EclipseETS/bms-slave-HW/E10/V1/Slave_front.png

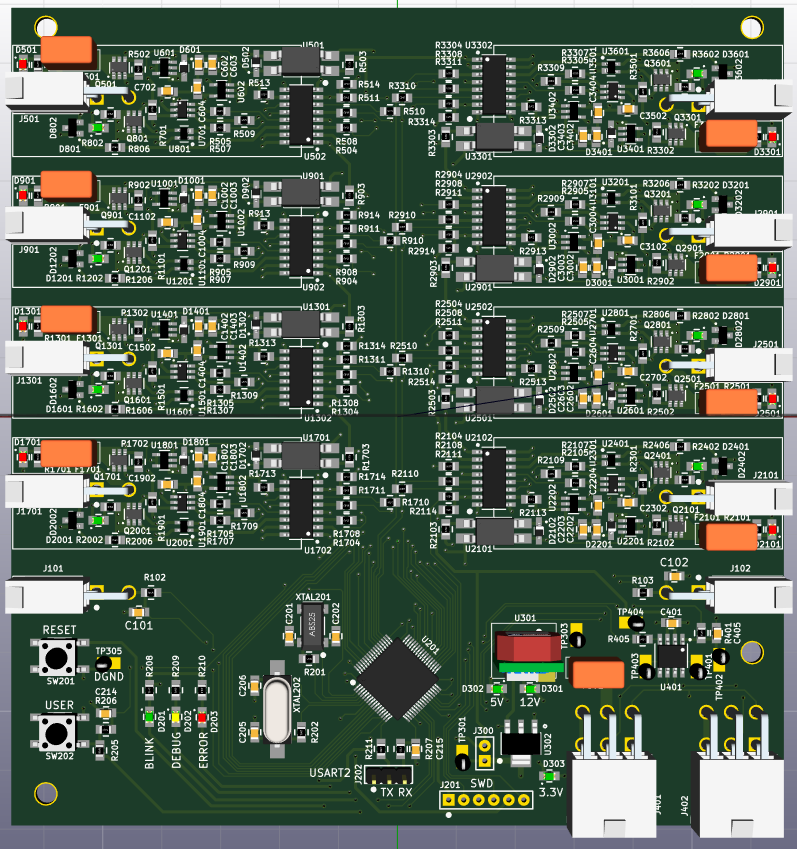
E10/V1/Slave_front.png
