EclipseETS/bms-slave-HW/README.md

# bms-slave-HW
Kicad project for slave board of the Eclipse solar car BMS
