EclipseETS/bms-slave-HW/E10/V1/Slave_back.png

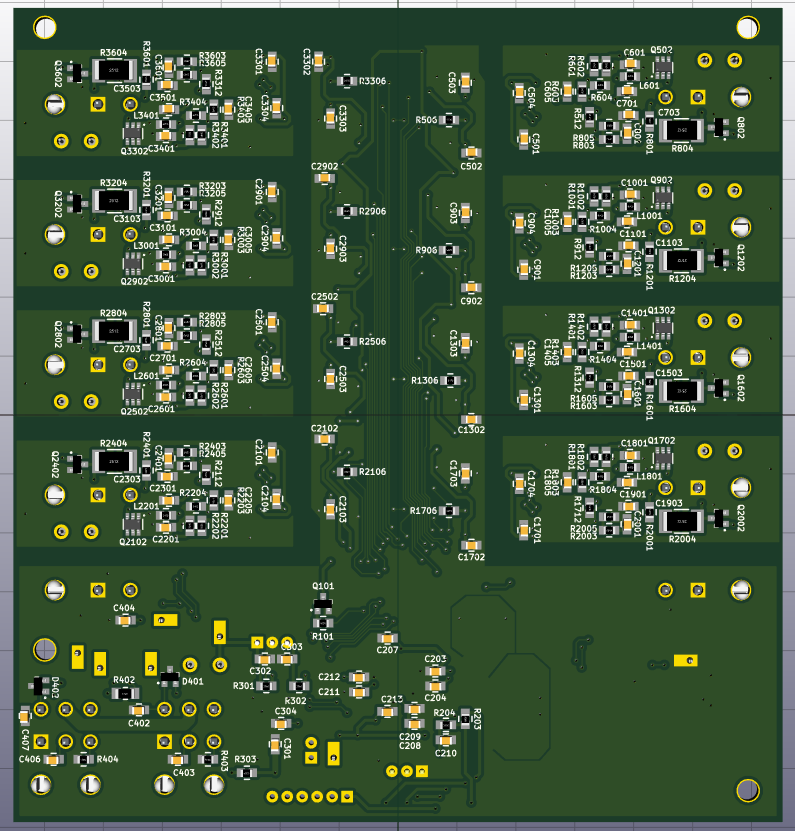
E10/V1/Slave_back.png
