EclipseETS/bms-slave-HW/E11/V1/Slave.kicad_pcb

## KiCad design E11/V1/Slave.kicad_pcb (2021-01-23)

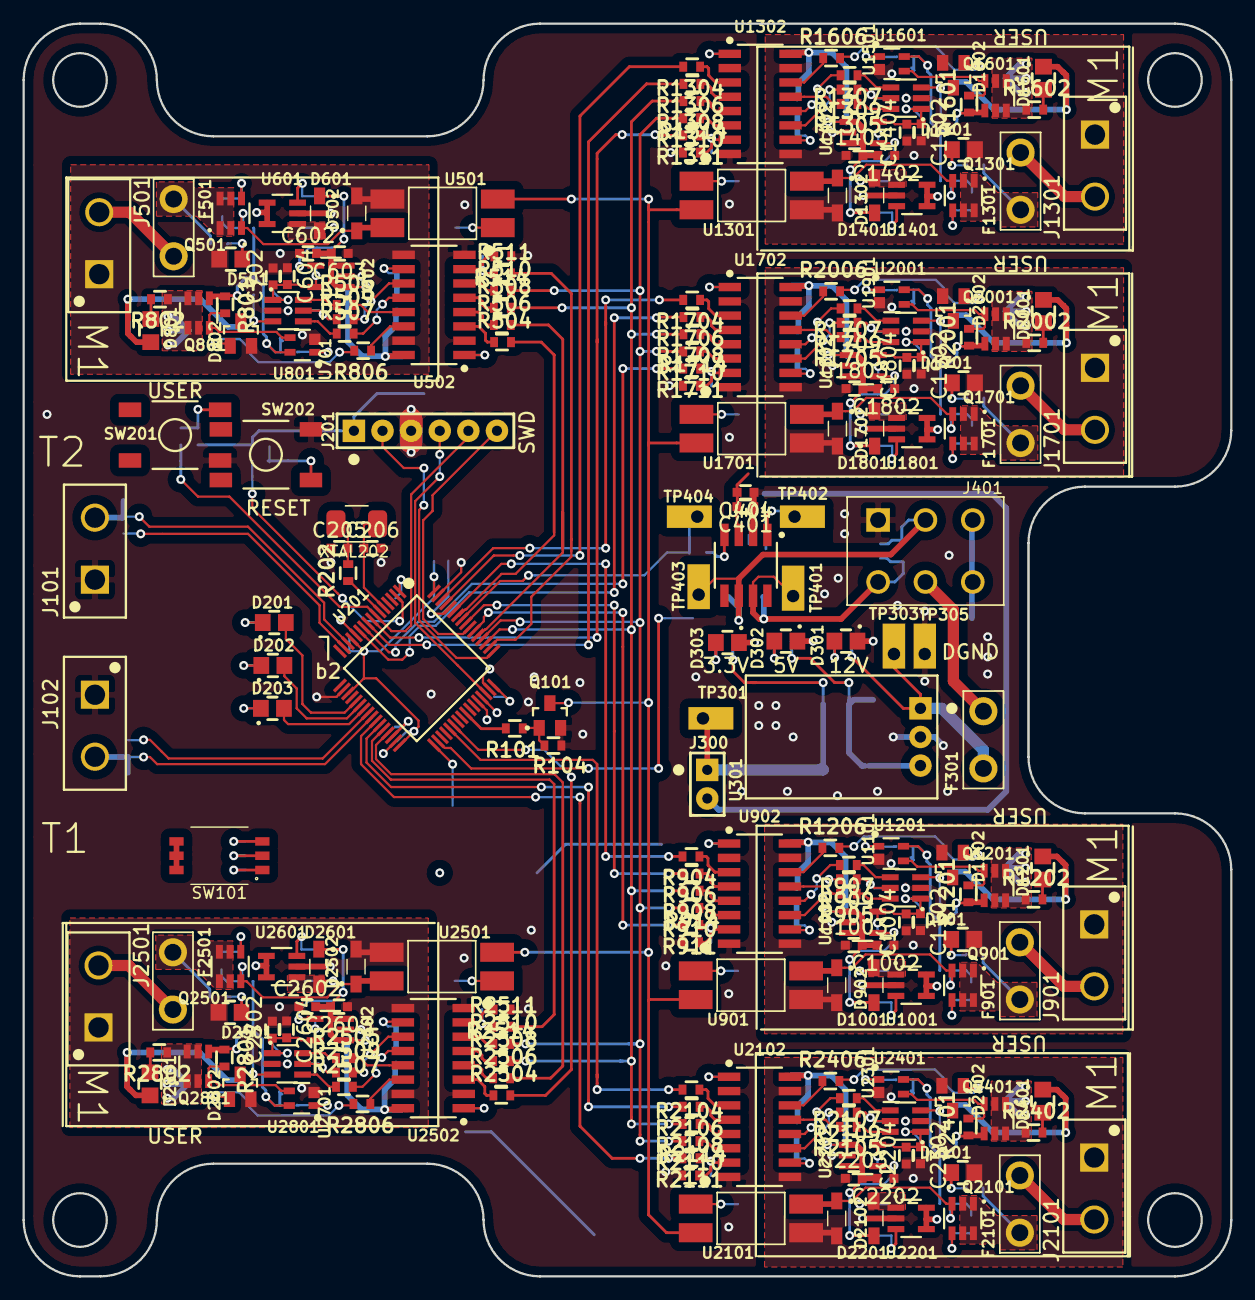
[picture p4: board Slave.kicad_pcb from above]

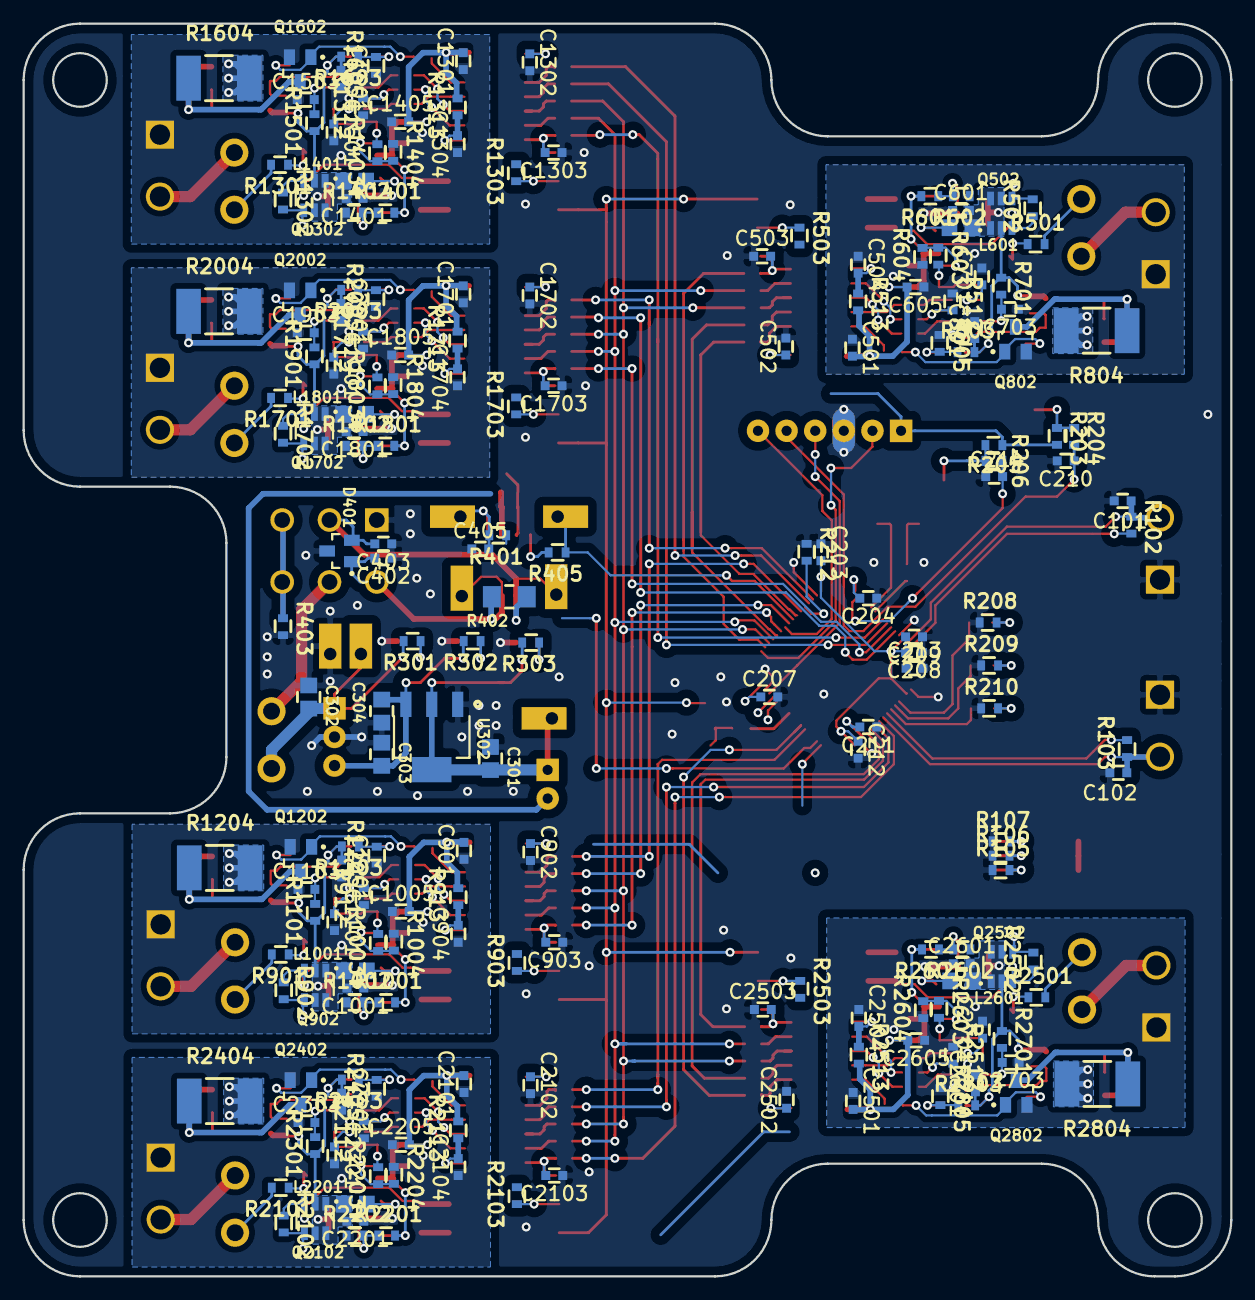
[picture p5: board Slave.kicad_pcb from below]

Board: 2 copper layers, 107.2 x 111.2 mm, 411 parts (191 on the bottom side), 263 nets.

Parts:
C101, C102, C204, C208, C401: 885012107015; C0603
C203, C207, C210, C212, C213, C214, C404: 885012207098; C0603
C205, C206, C402, C403: 885012007053; C0603
C209: 885012207092; C0603
C211: 885012107018; C0603
C301: 885012107005; C0805
C302, C303: 885012107018; C0805
C304: 885012107014; C0805
C405: 885012207080; C0603
C501, C502, C504, C702, C801, C901, C902, C904, C1102, C1201, C1301, C1302, C1304, C1502, C1601, C1701, C1702, C1704, C1902, C2001, C2101, C2102, C2104, C2302, C2401, C2501, C2502, C2504, C2702, C2801: 885012206095; C0603
C503, C903, C1303, C1703, C2103, C2503: 885012206077; C0603
C601, C602, C603, C604, C605, C1001, C1002, C1003, C1004, C1005, C1401, C1402, C1403, C1404, C1405, C1801, C1802, C1803, C1804, C1805, C2201, C2202, C2203, C2204, C2205, C2601, C2602, C2603, C2604, C2605: GRM188R61C106KAALD; C0603
C701, C1101, C1501, C1901, C2301, C2701: 885012106022; C0603
C703, C1103, C1503, C1903, C2303, C2703: 885012206073; C0603
D201, D301, D302, D303, D801, D1201, D1601, D2001, D2401, D2801: 150080VS75000; LED_0805_GREEN
D202: 150080YS75000; LED_0805_YELLOW
D203, D501, D901, D1301, D1701, D2101, D2501: 150080RS75000; LED_0805_RED
D401: D1213A-02SOL-7; SOT-23-3
D502, D601, D902, D1001, D1302, D1401, D1702, D1801, D2102, D2201, D2502, D2601: NSR0530HT1G; SOD-323
D802, D1202, D1602, D2002, D2402, D2802: MMBZ12VALT1G; SOT-23-3
F301, F501, F901, F1301, F1701, F2101, F2501: 39511000440; TE5_395
J101, J102, J501, J901, J1301, J1701, J2101, J2501: 64900221122
J201: Header_Male_Pin_2.54mm_1X6_,_Unshrouded; Headers_2.54mm_1X6
J300: Header_Male_Pin_2.54mm_1X2_,_Unshrouded; Headers_2.54mm_1X2
J401: 64900621122
L601, L1001, L1401, L1801, L2201, L2601: MLZ2012N101LT000; I0805
Q101: 2N7002P,215; SOT-23-3
Q501, Q502, Q801, Q901, Q902, Q1201, Q1301, Q1302, Q1601, Q1701, Q1702, Q2001, Q2101, Q2102, Q2401, Q2501, Q2502, Q2801: CPH6347-TL-W; TSOT-23-6
Q802, Q1202, Q1602, Q2002, Q2402, Q2802: BSS806NH6327XTSA1; SOT-23-3
R101, R208, R209, R210, R303: RC0805JR-07470RL; R0603
R102, R103: RC0805JR-0733KL; R0603
R104, R203, R205, R301: RC0805JR-074K7L; R0603
R105, R106, R107: RC0603JR-07470RL; R0603
R202, R403: RC0805JR-070RL; R0603
R204, R206, R401, R405: RC0805JR-07100RL; R0603
R212: RC0805JR-0710KL; R0603
R302: RC0805JR-071KL; R0603
R402: RC1206JR-07120RL; R1206
R501, R802, R901, R1202, R1301, R1602, R1701, R2002, R2101, R2402, R2501, R2802: RC0603JR-071KL; R0603
R502, R514, R801, R902, R914, R1201, R1302, R1314, R1601, R1702, R1714, R2001, R2102, R2114, R2401, R2502, R2514, R2801: RC0603JR-07470KL; R0603
R503, R903, R1303, R1703, R2103, R2503: RC0603JR-07330RL; R0603
R504, R505, R506, R507, R508, R509, R701, R904, R905, R906, R907, R908, R909, R1101, R1304, R1305, R1306, R1307, R1308, R1309, R1501, R1704, R1705, R1706, R1707, R1708, R1709, R1901, R2104, R2105, R2106, R2107, R2108, R2109, R2301, R2504, R2505, R2506, R2507, R2508, R2509, R2701: RC0603FR-07100RL; R0603
R510, R511, R512, R513, R603, R910, R911, R912, R913, R1003, R1310, R1311, R1312, R1313, R1403, R1710, R1711, R1712, R1713, R1803, R2110, R2111, R2112, R2113, R2203, R2510, R2511, R2512, R2513, R2603: RC0603JR-074K7L; R0603
R601, R1001, R1401, R1801, R2201, R2601: RC0603JR-071ML; R0603
R602, R1002, R1402, R1802, R2202, R2602: RC0603FR-07324KL; R0603
R604, R1004, R1404, R1804, R2204, R2604: RC0603FR-0712K1L; R0603
R803, R1203, R1603, R2003, R2403, R2803: RC0603JR-07560KL; R0603
R804, R1204, R1604, R2004, R2404, R2804: 352210RJT; R2512
R805, R1205, R1605, R2005, R2405, R2805: RC0603JR-07100KL; R0603
R806, R1206, R1606, R2006, R2406, R2806: RC0603JR-076K8L; R0603
SW101: DIP_SW_3; 416131160803
SW201, SW202: PTS645SM43SMTR92; PTS645_6X6X4_SMD
TP301, TP303, TP305, TP401, TP402, TP403, TP404: Test_Point_THM; Keystone_5001
U201: STM32F446RE; LQFP-64
U301: OKI-78SR-5/1.5-W36-C; OKI-78SR_Horizontal
U302: AZ1117IH-3.3TRG1; SOT-223-3
U401: SN65HVD232DR; SOIC-8
U501, U901, U1301, U1701, U2101, U2501: LTV-816S; 4-SMD
U502, U902, U1302, U1702, U2102, U2502: SI8641AB-B-IS1; SOIC-16
U601, U1001, U1401, U1801, U2201, U2601: AP3015KTR-G1; SOT-23-5
U602, U1002, U1402, U1802, U2202, U2602: AP2202K-ADJTRG1; SOT-23-5
U701, U1101, U1501, U1901, U2301, U2701: ADC121S021CIMF/NOPB; SOT-23-6
U801, U1201, U1601, U2001, U2401, U2801: ADCMP350YKSZ-REEL7; SC70-4
XTAL202: 7A-8.000MAHJ-T; TXC_7A_Series

Connections:
3.3V: C301.2, J300.1, R303.2, TP301.1, U302.2, U302.4
5V: C303.2, C304.2, R302.2, U301.3, U302.3
12V: C302.2, F301.2, R301.2, TP303.1, U301.1
/BALANCING_PWM_1: R504.2, U201.58
/BALANCING_PWM_2: R904.2, U201.59
/BALANCING_PWM_3: R1304.2, U201.61
/BALANCING_PWM_4: R1704.2, U201.62
/BALANCING_PWM_5: R2104.2, U201.37
/BALANCING_PWM_6: R2504.2, U201.38
/CAN1/CAN_N: C403.2, D401.2, J401.2, R402.2, TP403.1, U401.6
/CAN1/CAN_P: C402.2, D401.1, J401.4, R402.1, TP401.1, U401.7
/CAN1/Shield1: J401.3, J401.6, R403.1
/CAN2_RX: R405.1, TP404.1, U201.57
/CAN2_TX: R401.1, U201.34
/CS_1: R506.2, U201.53
/CS_2: R906.2, U201.56
/CS_3: R1306.2, U201.9
/CS_4: R1706.2, U201.11
/CS_5: R2106.2, U201.27
/CS_6: R2506.2, U201.29
/DATA_ENABLE_1: R511.2, U201.50
/DATA_ENABLE_2: R911.2, U201.54
/DATA_ENABLE_3: R1311.2, U201.8
/DATA_ENABLE_4: R1711.2, U201.10
/DATA_ENABLE_5: R2111.2, U201.26
/DATA_ENABLE_6: R2511.2, U201.28
/ID_0: R105.2, SW101.1, U201.33
/ID_1: R106.2, SW101.2, U201.44
/ID_2: R107.2, SW101.3, U201.45
/MISO: R510.2, R910.2, R1310.2, R1710.2, R2110.2, R2510.2, U201.52
/Module 1/+VREF: C604.2, C701.1, C702.1, R603.2, U602.5, U701.1
/Module 1/BALANCE_PWM: R806.1, U502.14
/Module 1/BVDD: C501.2, C602.2, C603.2, C605.2, D601.1, R513.2, R601.2, U502.16, U602.1, U602.3
/Module 1/Balancing/Drain_P_Mosfet: Q801.1, Q801.2, Q801.5, Q801.6, R802.1, R804.2
/Module 1/CELL+: F501.2, Q501.1, Q501.2, Q501.5, Q501.6, R501.2
/Module 1/CELL-: C501.1, C504.1, C601.1, C602.1, C603.1, C604.1, C605.1, C701.2, C702.2, C703.1, C801.2, D501.2, D502.2, D802.2, J501.1, Q802.2, R512.1, R602.1, R604.1, R805.1, U501.3, U502.9, U502.15, U601.2, U602.2, U701.2, U801.2
/Module 1/CELL_Voltage: C601.2, C801.1, L601.1, Q502.1, Q502.2, Q502.5, Q502.6, Q801.4, R701.1, R801.1, R803.2, U601.4, U601.5, U801.4
/Module 1/CS: R505.2, U502.13
/Module 1/Power Supply Front End/SW: D601.2, L601.2, U601.1
/Module 1/SCLK: R507.2, U502.12
/Module 1/SDATA: R509.2, U502.11
/Module 1/Voltage Reading/CS: R505.1, U701.6
/Module 1/Voltage Reading/SCLK: R507.1, U701.4
/Module 1/Voltage Reading/SDATA: R509.1, R512.2, U701.5
/Module 2/+VREF: C1004.2, C1101.1, C1102.1, R1003.2, U1002.5, U1101.1
/Module 2/BALANCE_PWM: R1206.1, U902.14
/Module 2/BVDD: C901.2, C1002.2, C1003.2, C1005.2, D1001.1, R913.2, R1001.2, U902.16, U1002.1, U1002.3
/Module 2/Balancing/Drain_P_Mosfet: Q1201.1, Q1201.2, Q1201.5, Q1201.6, R1202.1, R1204.2
/Module 2/CELL+: F901.2, Q901.1, Q901.2, Q901.5, Q901.6, R901.2
/Module 2/CELL-: C901.1, C904.1, C1001.1, C1002.1, C1003.1, C1004.1, C1005.1, C1101.2, C1102.2, C1103.1, C1201.2, D901.2, D902.2, D1202.2, J901.1, Q1202.2, R912.1, R1002.1, R1004.1, R1205.1, U901.3, U902.9, U902.15, U1001.2, U1002.2, U1101.2, U1201.2
/Module 2/CELL_Voltage: C1001.2, C1201.1, L1001.1, Q902.1, Q902.2, Q902.5, Q902.6, Q1201.4, R1101.1, R1201.1, R1203.2, U1001.4, U1001.5, U1201.4
/Module 2/CS: R905.2, U902.13
/Module 2/Power Supply Front End/SW: D1001.2, L1001.2, U1001.1
/Module 2/SCLK: R907.2, U902.12
/Module 2/SDATA: R909.2, U902.11
/Module 2/Voltage Reading/CS: R905.1, U1101.6
/Module 2/Voltage Reading/SCLK: R907.1, U1101.4
/Module 2/Voltage Reading/SDATA: R909.1, R912.2, U1101.5
/Module 3/+VREF: C1404.2, C1501.1, C1502.1, R1403.2, U1402.5, U1501.1
/Module 3/BALANCE_PWM: R1606.1, U1302.14
/Module 3/BVDD: C1301.2, C1402.2, C1403.2, C1405.2, D1401.1, R1313.2, R1401.2, U1302.16, U1402.1, U1402.3
/Module 3/Balancing/Drain_P_Mosfet: Q1601.1, Q1601.2, Q1601.5, Q1601.6, R1602.1, R1604.2
/Module 3/CELL+: F1301.2, Q1301.1, Q1301.2, Q1301.5, Q1301.6, R1301.2
/Module 3/CELL-: C1301.1, C1304.1, C1401.1, C1402.1, C1403.1, C1404.1, C1405.1, C1501.2, C1502.2, C1503.1, C1601.2, D1301.2, D1302.2, D1602.2, J1301.1, Q1602.2, R1312.1, R1402.1, R1404.1, R1605.1, U1301.3, U1302.9, U1302.15, U1401.2, U1402.2, U1501.2, U1601.2
/Module 3/CELL_Voltage: C1401.2, C1601.1, L1401.1, Q1302.1, Q1302.2, Q1302.5, Q1302.6, Q1601.4, R1501.1, R1601.1, R1603.2, U1401.4, U1401.5, U1601.4
/Module 3/CS: R1305.2, U1302.13
/Module 3/Power Supply Front End/SW: D1401.2, L1401.2, U1401.1
/Module 3/SCLK: R1307.2, U1302.12
/Module 3/SDATA: R1309.2, U1302.11
/Module 3/Voltage Reading/CS: R1305.1, U1501.6
/Module 3/Voltage Reading/SCLK: R1307.1, U1501.4
/Module 3/Voltage Reading/SDATA: R1309.1, R1312.2, U1501.5
/Module 4/+VREF: C1804.2, C1901.1, C1902.1, R1803.2, U1802.5, U1901.1
/Module 4/BALANCE_PWM: R2006.1, U1702.14
/Module 4/BVDD: C1701.2, C1802.2, C1803.2, C1805.2, D1801.1, R1713.2, R1801.2, U1702.16, U1802.1, U1802.3
/Module 4/Balancing/Drain_P_Mosfet: Q2001.1, Q2001.2, Q2001.5, Q2001.6, R2002.1, R2004.2
/Module 4/CELL+: F1701.2, Q1701.1, Q1701.2, Q1701.5, Q1701.6, R1701.2
/Module 4/CELL-: C1701.1, C1704.1, C1801.1, C1802.1, C1803.1, C1804.1, C1805.1, C1901.2, C1902.2, C1903.1, C2001.2, D1701.2, D1702.2, D2002.2, J1701.1, Q2002.2, R1712.1, R1802.1, R1804.1, R2005.1, U1701.3, U1702.9, U1702.15, U1801.2, U1802.2, U1901.2, U2001.2
/Module 4/CELL_Voltage: C1801.2, C2001.1, L1801.1, Q1702.1, Q1702.2, Q1702.5, Q1702.6, Q2001.4, R1901.1, R2001.1, R2003.2, U1801.4, U1801.5, U2001.4
/Module 4/CS: R1705.2, U1702.13
/Module 4/Power Supply Front End/SW: D1801.2, L1801.2, U1801.1
/Module 4/SCLK: R1707.2, U1702.12
/Module 4/SDATA: R1709.2, U1702.11
/Module 4/Voltage Reading/CS: R1705.1, U1901.6
/Module 4/Voltage Reading/SCLK: R1707.1, U1901.4
/Module 4/Voltage Reading/SDATA: R1709.1, R1712.2, U1901.5
/Module 5/+VREF: C2204.2, C2301.1, C2302.1, R2203.2, U2202.5, U2301.1
/Module 5/BALANCE_PWM: R2406.1, U2102.14
/Module 5/BVDD: C2101.2, C2202.2, C2203.2, C2205.2, D2201.1, R2113.2, R2201.2, U2102.16, U2202.1, U2202.3
/Module 5/Balancing/Drain_P_Mosfet: Q2401.1, Q2401.2, Q2401.5, Q2401.6, R2402.1, R2404.2
/Module 5/CELL+: F2101.2, Q2101.1, Q2101.2, Q2101.5, Q2101.6, R2101.2
/Module 5/CELL-: C2101.1, C2104.1, C2201.1, C2202.1, C2203.1, C2204.1, C2205.1, C2301.2, C2302.2, C2303.1, C2401.2, D2101.2, D2102.2, D2402.2, J2101.1, Q2402.2, R2112.1, R2202.1, R2204.1, R2405.1, U2101.3, U2102.9, U2102.15, U2201.2, U2202.2, U2301.2, U2401.2
/Module 5/CELL_Voltage: C2201.2, C2401.1, L2201.1, Q2102.1, Q2102.2, Q2102.5, Q2102.6, Q2401.4, R2301.1, R2401.1, R2403.2, U2201.4, U2201.5, U2401.4
/Module 5/CS: R2105.2, U2102.13
/Module 5/Power Supply Front End/SW: D2201.2, L2201.2, U2201.1
/Module 5/SCLK: R2107.2, U2102.12
/Module 5/SDATA: R2109.2, U2102.11
/Module 5/Voltage Reading/CS: R2105.1, U2301.6
/Module 5/Voltage Reading/SCLK: R2107.1, U2301.4
/Module 5/Voltage Reading/SDATA: R2109.1, R2112.2, U2301.5
/Module 6/+VREF: C2604.2, C2701.1, C2702.1, R2603.2, U2602.5, U2701.1
/Module 6/BALANCE_PWM: R2806.1, U2502.14
/Module 6/BVDD: C2501.2, C2602.2, C2603.2, C2605.2, D2601.1, R2513.2, R2601.2, U2502.16, U2602.1, U2602.3
/Module 6/Balancing/Drain_P_Mosfet: Q2801.1, Q2801.2, Q2801.5, Q2801.6, R2802.1, R2804.2
/Module 6/CELL+: F2501.2, Q2501.1, Q2501.2, Q2501.5, Q2501.6, R2501.2
/Module 6/CELL-: C2501.1, C2504.1, C2601.1, C2602.1, C2603.1, C2604.1, C2605.1, C2701.2, C2702.2, C2703.1, C2801.2, D2501.2, D2502.2, D2802.2, J2501.1, Q2802.2, R2512.1, R2602.1, R2604.1, R2805.1, U2501.3, U2502.9, U2502.15, U2601.2, U2602.2, U2701.2, U2801.2
/Module 6/CELL_Voltage: C2601.2, C2801.1, L2601.1, Q2502.1, Q2502.2, Q2502.5, Q2502.6, Q2801.4, R2701.1, R2801.1, R2803.2, U2601.4, U2601.5, U2801.4
/Module 6/CS: R2505.2, U2502.13
/Module 6/Power Supply Front End/SW: D2601.2, L2601.2, U2601.1
/Module 6/SCLK: R2507.2, U2502.12
/Module 6/SDATA: R2509.2, U2502.11
/Module 6/Voltage Reading/CS: R2505.1, U2701.6
/Module 6/Voltage Reading/SCLK: R2507.1, U2701.4
/Module 6/Voltage Reading/SDATA: R2509.1, R2512.2, U2701.5
/NRST: C210.1, J201.5, R204.2, U201.7
/NTC_1_ADC: C101.2, J101.2, R102.1, U201.14
/NTC_1_GPIO: R102.2, U201.15
/NTC_2_ADC: C102.2, J102.2, R103.1, U201.25
/NTC_2_GPIO: R103.2, U201.24
/PA5: D201.2, U201.21
/PA6: D202.2, U201.22
/PA7: D203.2, U201.23
/PWR_ENABLE: Q101.3, U501.2, U901.2, U1301.2, U1701.2, U2101.2, U2501.2
/PWR_ENABLE_GPIO: R101.2, U201.41
/SCLK: R508.2, R908.2, R1308.2, R1708.2, R2108.2, R2508.2, U201.51
/STM32F446/SWCLK: J201.2, U201.49
/STM32F446/SWDIO: J201.4, U201.46
/STM32F446/SWO: J201.6, U201.55
/STM32F446/USER_BTN: C214.1, R206.2, U201.2
/VBat: C204.2, U201.1
CAN_PWR: F301.1, J401.5
DGND: C101.1, C102.1, C203.1, C204.1, C205.1, C206.2, C207.2, C208.1, C209.1, C210.2, C211.1, C212.2, C213.2, C214.2, C301.1, C302.1, C303.1, C304.1, C401.1, C402.1, C403.1, C404.1, C405.1, C502.2, C503.1, C902.2, C903.1, C1302.2, C1303.1, C1702.2, C1703.1, C2102.2, C2103.1, C2502.2, C2503.1, D301.1, D302.1, D303.1, D401.3, J101.1, J102.1, J201.3, J401.1, Q101.2, R104.1, R105.1, R106.1, R107.1, R208.1, R209.1, R210.1, R212.1, R403.2, R514.1, R914.1, R1314.1, R1714.1, R2114.1, R2514.1, SW201.4, SW202.3, TP305.1, U201.12, U201.18, U201.31, U201.47, U201.63, U301.2, U302.1, U401.2, U502.2, U502.8, U902.2, U902.8, U1302.2, U1302.8, U1702.2, U1702.8, U2102.2, U2102.8, U2502.2, U2502.8
unnamed: C205.2, R202.2, XTAL202.1
unnamed: C206.1, U201.5, XTAL202.2
unnamed: C211.2, U201.30
unnamed: C405.2, R401.2, TP402.1, U401.1
unnamed: C503.2, R511.1, R514.2, U502.7
unnamed: C504.2, R513.1, U502.10
unnamed: C703.2, R701.2, U701.3
unnamed: C903.2, R911.1, R914.2, U902.7
unnamed: C904.2, R913.1, U902.10
unnamed: C1103.2, R1101.2, U1101.3
unnamed: C1303.2, R1311.1, R1314.2, U1302.7
unnamed: C1304.2, R1313.1, U1302.10
unnamed: C1503.2, R1501.2, U1501.3
unnamed: C1703.2, R1711.1, R1714.2, U1702.7
unnamed: C1704.2, R1713.1, U1702.10
unnamed: C1903.2, R1901.2, U1901.3
unnamed: C2103.2, R2111.1, R2114.2, U2102.7
unnamed: C2104.2, R2113.1, U2102.10
unnamed: C2303.2, R2301.2, U2301.3
unnamed: C2503.2, R2511.1, R2514.2, U2502.7
unnamed: C2504.2, R2513.1, U2502.10
unnamed: C2703.2, R2701.2, U2701.3
unnamed: D201.1, R208.2
unnamed: D202.1, R209.2
unnamed: D203.1, R210.2
unnamed: D301.2, R301.1
unnamed: D302.2, R302.1
unnamed: D303.2, R303.1
unnamed: D501.1, R501.1
unnamed: D502.1, Q501.3, Q502.3, R502.1, U501.4
unnamed: D801.1, Q802.3, R804.1
unnamed: D801.2, R802.2
unnamed: D802.1, Q802.1, R806.2
unnamed: D901.1, R901.1
unnamed: D902.1, Q901.3, Q902.3, R902.1, U901.4
unnamed: D1201.1, Q1202.3, R1204.1
unnamed: D1201.2, R1202.2
unnamed: D1202.1, Q1202.1, R1206.2
unnamed: D1301.1, R1301.1
unnamed: D1302.1, Q1301.3, Q1302.3, R1302.1, U1301.4
unnamed: D1601.1, Q1602.3, R1604.1
unnamed: D1601.2, R1602.2
unnamed: D1602.1, Q1602.1, R1606.2
unnamed: D1701.1, R1701.1
unnamed: D1702.1, Q1701.3, Q1702.3, R1702.1, U1701.4
unnamed: D2001.1, Q2002.3, R2004.1
unnamed: D2001.2, R2002.2
unnamed: D2002.1, Q2002.1, R2006.2
unnamed: D2101.1, R2101.1
unnamed: D2102.1, Q2101.3, Q2102.3, R2102.1, U2101.4
unnamed: D2401.1, Q2402.3, R2404.1
unnamed: D2401.2, R2402.2
unnamed: D2402.1, Q2402.1, R2406.2
unnamed: D2501.1, R2501.1
unnamed: D2502.1, Q2501.3, Q2502.3, R2502.1, U2501.4
unnamed: D2801.1, Q2802.3, R2804.1
unnamed: D2801.2, R2802.2
unnamed: D2802.1, Q2802.1, R2806.2
unnamed: F501.1, J501.2
unnamed: F901.1, J901.2
unnamed: F1301.1, J1301.2
unnamed: F1701.1, J1701.2
unnamed: F2101.1, J2101.2
unnamed: F2501.1, J2501.2
unnamed: Q101.1, R101.1, R104.2
unnamed: Q501.4, Q502.4, R502.2
unnamed: Q801.3, R801.2, U801.3
unnamed: Q901.4, Q902.4, R902.2
unnamed: Q1201.3, R1201.2, U1201.3
unnamed: Q1301.4, Q1302.4, R1302.2
unnamed: Q1601.3, R1601.2, U1601.3
unnamed: Q1701.4, Q1702.4, R1702.2
unnamed: Q2001.3, R2001.2, U2001.3
unnamed: Q2101.4, Q2102.4, R2102.2
unnamed: Q2401.3, R2401.2, U2401.3
unnamed: Q2501.4, Q2502.4, R2502.2
unnamed: Q2801.3, R2801.2, U2801.3
unnamed: R202.1, U201.6
unnamed: R203.1, R204.1, SW201.2
unnamed: R205.1, R206.1, SW202.1
unnamed: R212.2, U201.60
unnamed: R405.2, U401.4
unnamed: R503.1, U501.1
unnamed: R504.1, U502.3
unnamed: R506.1, U502.4
unnamed: R508.1, U502.5
unnamed: R510.1, U502.6
unnamed: R601.1, R602.2, U601.3
unnamed: R603.1, R604.2, U602.4
unnamed: R803.1, R805.2, U801.1
unnamed: R903.1, U901.1
unnamed: R904.1, U902.3
unnamed: R906.1, U902.4
unnamed: R908.1, U902.5
unnamed: R910.1, U902.6
unnamed: R1001.1, R1002.2, U1001.3
unnamed: R1003.1, R1004.2, U1002.4
unnamed: R1203.1, R1205.2, U1201.1
unnamed: R1303.1, U1301.1
unnamed: R1304.1, U1302.3
unnamed: R1306.1, U1302.4
unnamed: R1308.1, U1302.5
unnamed: R1310.1, U1302.6
unnamed: R1401.1, R1402.2, U1401.3
unnamed: R1403.1, R1404.2, U1402.4
unnamed: R1603.1, R1605.2, U1601.1
unnamed: R1703.1, U1701.1
unnamed: R1704.1, U1702.3
unnamed: R1706.1, U1702.4
unnamed: R1708.1, U1702.5
unnamed: R1710.1, U1702.6
unnamed: R1801.1, R1802.2, U1801.3
unnamed: R1803.1, R1804.2, U1802.4
unnamed: R2003.1, R2005.2, U2001.1
unnamed: R2103.1, U2101.1
unnamed: R2104.1, U2102.3
unnamed: R2106.1, U2102.4
unnamed: R2108.1, U2102.5
unnamed: R2110.1, U2102.6
unnamed: R2201.1, R2202.2, U2201.3
unnamed: R2203.1, R2204.2, U2202.4
unnamed: R2403.1, R2405.2, U2401.1
unnamed: R2503.1, U2501.1
unnamed: R2504.1, U2502.3
unnamed: R2506.1, U2502.4
unnamed: R2508.1, U2502.5
unnamed: R2510.1, U2502.6
unnamed: R2601.1, R2602.2, U2601.3
unnamed: R2603.1, R2604.2, U2602.4
unnamed: R2803.1, R2805.2, U2801.1
VDD: C203.2, C207.1, C208.2, C209.2, C212.1, C213.1, C401.2, C404.2, C502.1, C902.1, C1302.1, C1702.1, C2102.1, C2502.1, J201.1, J300.2, R203.2, R205.2, R503.2, R903.2, R1303.2, R1703.2, R2103.2, R2503.2, SW101.4, SW101.5, SW101.6, U201.13, U201.19, U201.32, U201.48, U201.64, U401.3, U502.1, U902.1, U1302.1, U1702.1, U2102.1, U2502.1
