EclipseETS/bms-slave-HW/E10/V1/Slave.ioc

Mcu.UserName=STM32F446RETx
PA0-WKUP.GPIO_Label=NTC_1_ADC
PA0-WKUP.Signal=ADCx_IN0
PA1.GPIO_Label=NTC_1_EN
PA1.Signal=GPIO_Output
PA10.GPIO_Label=CS_8
PA10.Signal=GPIO_Output
PA11.GPIO_Label=ID_1
PA11.Signal=GPIO_Output
PA12.GPIO_Label=ID_2
PA12.Signal=GPIO_Output
PA13.GPIO_Label=TMS
PA13.Signal=SYS_JTMS-SWDIO
PA14.GPIO_Label=TCK
PA14.Signal=SYS_JTCK-SWCLK
PA15.GPIO_Label=DE_1
PA15.Signal=GPIO_Output
PA2.GPIO_Label=USART_TX
PA2.Signal=USART2_TX
PA3.GPIO_Label=USART_RX
PA3.Signal=USART2_RX
PA5.GPIO_Label=LED_BLINK
PA5.Signal=GPIO_Output
PA6.GPIO_Label=LED_DEBUG
PA6.Signal=GPIO_Output
PA7.GPIO_Label=LED_ERROR
PA7.Signal=GPIO_Output
PA8.GPIO_Label=POWER_EN
PA8.Signal=GPIO_Output
PA9.GPIO_Label=DE_8
PA9.Signal=GPIO_Output
PB0.GPIO_Label=DE_5
PB0.Signal=GPIO_Output
PB1.GPIO_Label=CS_5
PB1.Signal=GPIO_Output
PB10.GPIO_Label=CS_6
PB10.Signal=GPIO_Output
PB12.GPIO_Label=ID_0
PB12.Signal=GPIO_Output
PB13.Signal=CAN2_TX
PB14.GPIO_Label=DE_7
PB14.Signal=GPIO_Output
PB15.GPIO_Label=CS_7
PB15.Signal=GPIO_Output
PB2.GPIO_Label=DE_6
PB2.Signal=GPIO_Output
PB3.GPIO_Label=SWO
PB3.Signal=SYS_JTDO-SWO
PB4.GPIO_Label=CS_2
PB4.Signal=GPIO_Output
PB5.Signal=CAN2_RX
PB6.GPIO_Label=BALANCING_PWM_5
PB6.Signal=S_TIM4_CH1
PB7.GPIO_Label=BALANCING_PWM_6
PB7.Signal=S_TIM4_CH2
PB8.GPIO_Label=BALANCING_PWM_7
PB8.Signal=S_TIM4_CH3
PB9.GPIO_Label=BALANCING_PWM_8
PB9.Signal=S_TIM4_CH4
PC0.GPIO_Label=DE_3
PC0.Signal=GPIO_Output
PC1.GPIO_Label=CS_3
PC1.Signal=GPIO_Output
PC10.Signal=SPI3_SCK
PC11.Signal=SPI3_MISO
PC12.GPIO_Label=CS_1
PC12.Signal=GPIO_Output
PC13.GPIO_Label=BTN_USER
PC13.Signal=GPXTI13
PC14-OSC32_IN.Signal=RCC_OSC32_IN
PC15-OSC32_OUT.Signal=RCC_OSC32_OUT
PC2.GPIO_Label=DE_4
PC2.Signal=GPIO_Output
PC3.GPIO_Label=CS_4
PC3.Signal=GPIO_Output
PC4.GPIO_Label=NTC_2_EN
PC4.Signal=GPIO_Output
PC5.GPIO_Label=NTC_2_ADC
PC5.Signal=ADCx_IN15
PC6.GPIO_Label=BALANCING_PWM_1
PC6.Signal=S_TIM8_CH1
PC7.GPIO_Label=BALANCING_PWM_2
PC7.Signal=S_TIM8_CH2
PC8.GPIO_Label=BALANCING_PWM_3
PC8.Signal=S_TIM8_CH3
PC9.GPIO_Label=BALANCING_PWM_4
PC9.Signal=S_TIM8_CH4
PD2.GPIO_Label=DE_2
PD2.Signal=GPIO_Output
PH0-OSC_IN.Signal=RCC_OSC_IN
PH1-OSC_OUT.Signal=RCC_OSC_OUT
