EclipseETS/bms-slave-HW/(commit log)

2020-05-03 Add E10 Slave and create E11 folder for new design
    [CAN-2019-01-18-20-08-57.sch, CAN.sch, Isolated_BMS_Slave_Front_End-2019-01-18-20-08-57.sch, Isolated_BMS_Slave_Front_End.sch, Power Supply-2019-01-18-20-08-57.sch, Power Supply.sch, STM32F446-2019-01-18-20-08-57.sch, STM32F446.sch]
2020-05-04 start of project on new branch
    [Slave.kicad_pcb]
2020-05-04 update for missing resistor
    [CAN.sch, Isolated_BMS_Slave_Front_End.sch, Power Supply.sch, STM32F446.sch, Slave.kicad_pcb, Slave.sch, balancing.sch, power_supply_front_end.sch]
2020-06-12 begin mod module 0805 to 0603 res and caps
    [Slave.kicad_pcb]
2020-06-13 size reduction of modules using 0603 components
    [Isolated_BMS_Slave_Front_End.sch, Slave.kicad_pcb, Slave.sch, balancing.sch, power_supply_front_end.sch, voltage_reading.sch]
2020-06-26 progress save
    [Slave.kicad_pcb]
2020-09-07 most of the parts have been migrated to new board outline
    [CAN.sch, Power Supply.sch, STM32F446.sch, Slave.kicad_pcb, Slave.sch]
2020-09-09 initial component placement done
    [CAN.sch, STM32F446.sch, Slave.kicad_pcb, Slave.sch]
2020-09-17 updated filter values and pcb
    [Isolated_BMS_Slave_Front_End.sch, Slave.kicad_pcb, voltage_reading.sch]
2021-01-02 more routing
    [Slave.kicad_pcb]
2021-01-23 optimization time
    [Slave.kicad_pcb]
