EclipseETS/bms-slave-HW/(notices)

Notices in the files:
E10/V1/Slave.kicad_pcb:
(c) 2019 - Eclipse X
